aannuzzi/remote-monitoring/README.md

# remote-monitoring
Cal Poly Senior Project
