aannuzzi/remote-monitoring/eagle/senior_project_rev4.brd

## EAGLE design eagle/senior_project_rev4.brd (2016-09-23)

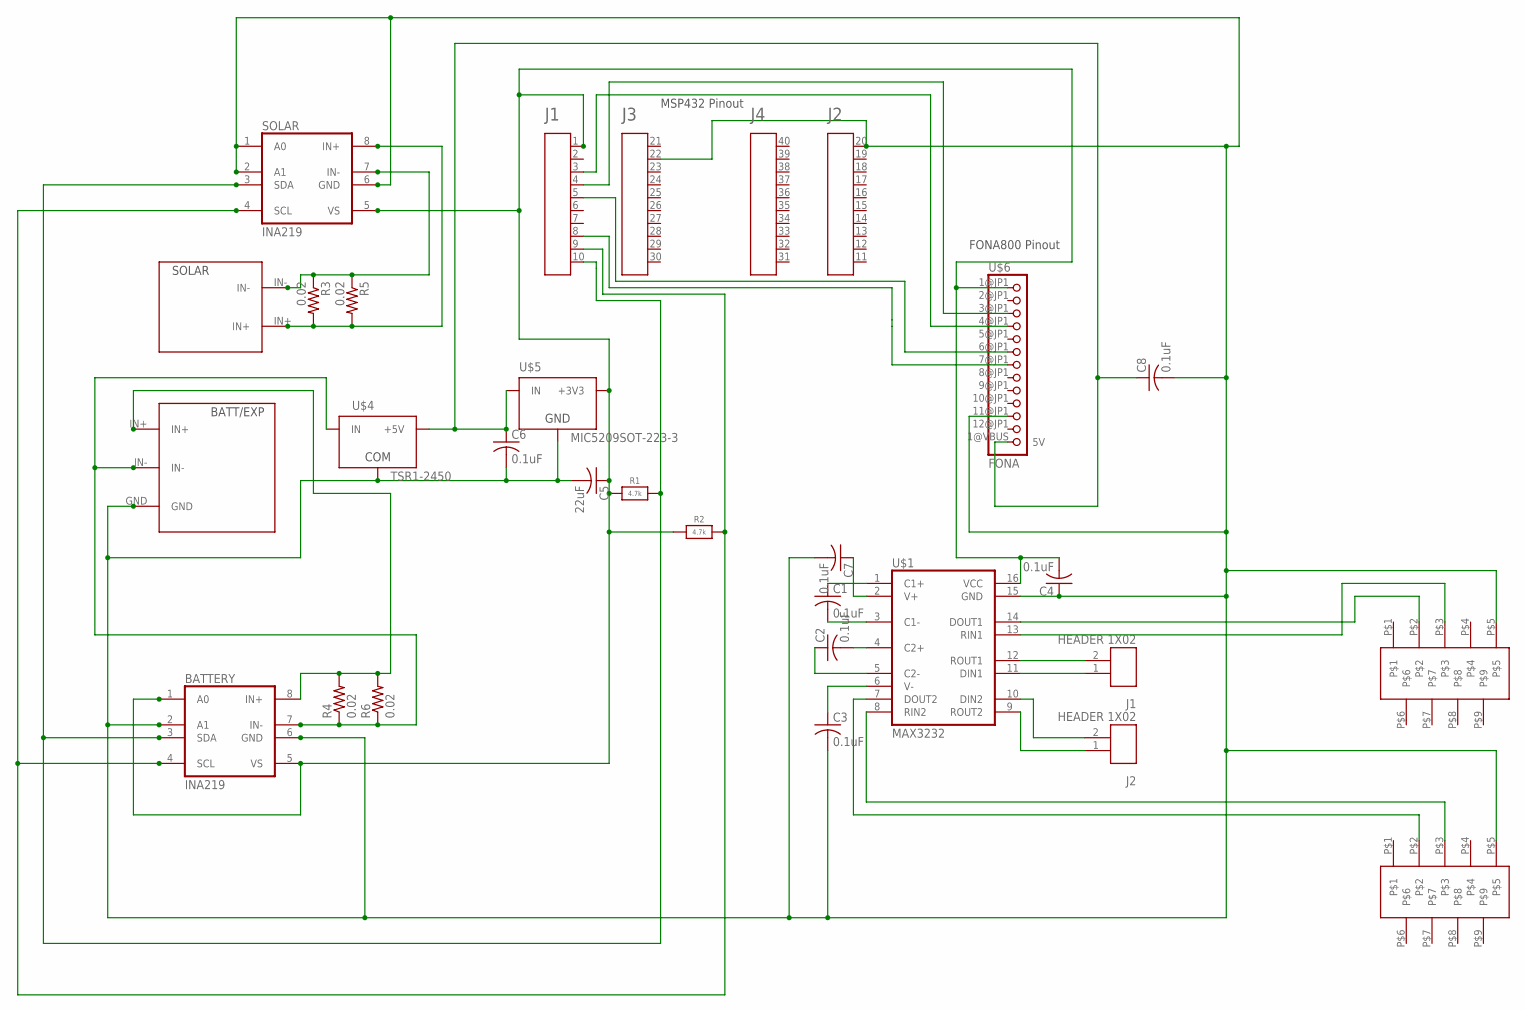
[picture p8: schematic senior_project_rev4.sch]

Parts:
A1: MSP432; 4X10-BOOSTERPACK
BATTERY: INA219; SO08
C1, C2, C3, C4, C6, C7, C8: 0.1uF; C1206
C5: 22uF; C1206
J1, J2: HEADER 1X02; 1X02
R1, R2: 4.7k; _1206
R3, R4, R5, R6: 0.02; R2512
RS232-1, RS232-2: XM2C-9; XM2C
SOLAR: INA219; SO08
U$1: MAX3232; SO16
U$2: TERM-3
U$3: TERM-2
U$4: TSR1-2450; TSR-1
U$5: MIC5209SOT-223-3; SOT-223
U$6: FONA; JP1_ADAFRUIT-FONA-800-GSM-BREAKOUT

Connections:
3.3V: A1.1, BATTERY.1 (A0), BATTERY.5 (VS), C4.2, C5.1, R1.1, R2.1, SOLAR.5 (VS), U$1.16 (VCC), U$5.3 (+3V3), U$6.1@JP1 (VIO)
5V: C6.1, C8.1, U$4.3 (+5V), U$5.1 (IN), U$6.1@VBUS (5V)
12V: BATTERY.7 (IN-), R4.1, R6.1, U$2.IN-, U$4.1 (IN)
GND: A1.20, A1.22, BATTERY.2 (A1), BATTERY.6 (GND), C3.2, C4.1, C5.2, C6.2, C7.2, C8.2, RS232-1.P$5, RS232-2.P$5, SOLAR.1 (A0), SOLAR.2 (A1), SOLAR.6 (GND), U$1.15 (GND), U$2.GND, U$4.2 (COM), U$5.2 (GND), U$5.4 (GND), U$6.11@JP1 (GND)
unnamed: C3.1, U$1.6 (V-)
unnamed: RS232-2.P$2, U$1.7 (DOUT2)
unnamed: A1.8, U$6.7@JP1 (PS)
unnamed: R3.1, R5.1, SOLAR.7 (IN-), U$3.IN-
unnamed: R3.2, R5.2, SOLAR.8 (IN+), U$3.IN+
unnamed: J1.2, U$1.12 (ROUT1)
unnamed: A1.10, BATTERY.3 (SDA), R1.2, SOLAR.3 (SDA)
unnamed: C1.2, U$1.3 (C1-)
unnamed: C1.1, U$1.1 (C1+)
unnamed: C2.2, U$1.4 (C2+)
unnamed: C2.1, U$1.5 (C2-)
unnamed: C7.1, U$1.2 (V+)
unnamed: RS232-1.P$2, U$1.14 (DOUT1)
unnamed: RS232-1.P$3, U$1.13 (RIN1)
unnamed: RS232-2.P$3, U$1.8 (RIN2)
unnamed: A1.9, BATTERY.4 (SCL), R2.2, SOLAR.4 (SCL)
unnamed: A1.5, U$6.6@JP1 (KEY)
unnamed: A1.4, U$6.3@JP1 (RX)
unnamed: A1.3, U$6.4@JP1 (TX)
unnamed: J1.1, U$1.11 (DIN1)
unnamed: J2.2, U$1.10 (DIN2)
unnamed: J2.1, U$1.9 (ROUT2)
unnamed: BATTERY.8 (IN+), R4.2, R6.2, U$2.IN+

Notes on the sheet:
MSP432 Pinout
FONA800 Pinout
SOLAR
BATT/EXP

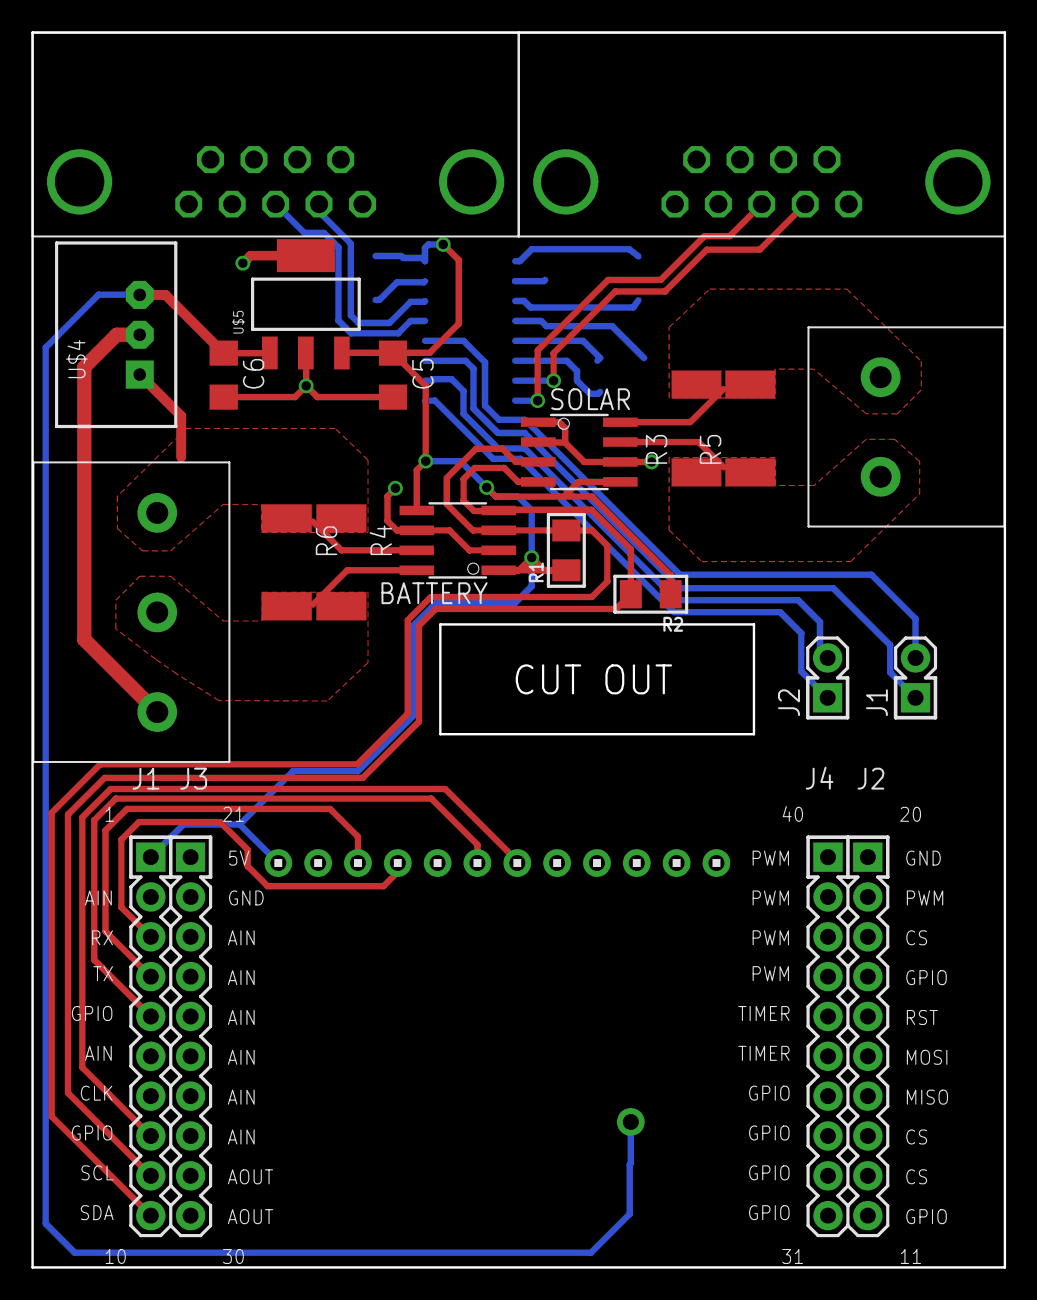
[picture p9: board senior_project_rev4.brd from above]

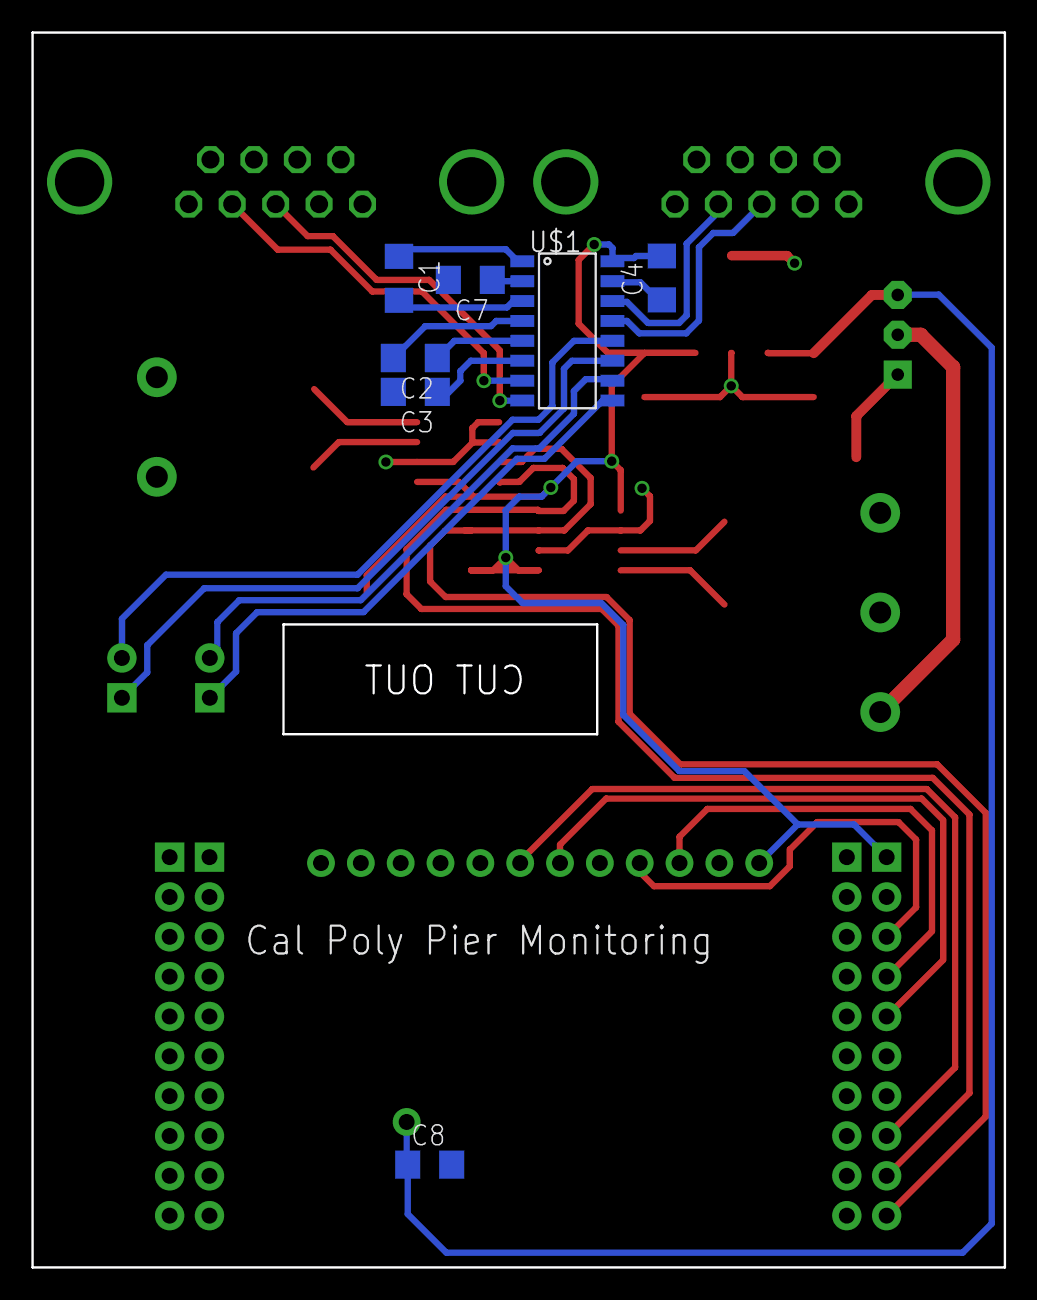
[picture p10: board senior_project_rev4.brd from below]

Board: 2 copper layers, 62.0 x 78.7 mm, 27 parts (7 on the bottom side), 27 nets.
